splatski/hackyflasher/README.md

# Hacky Flasher

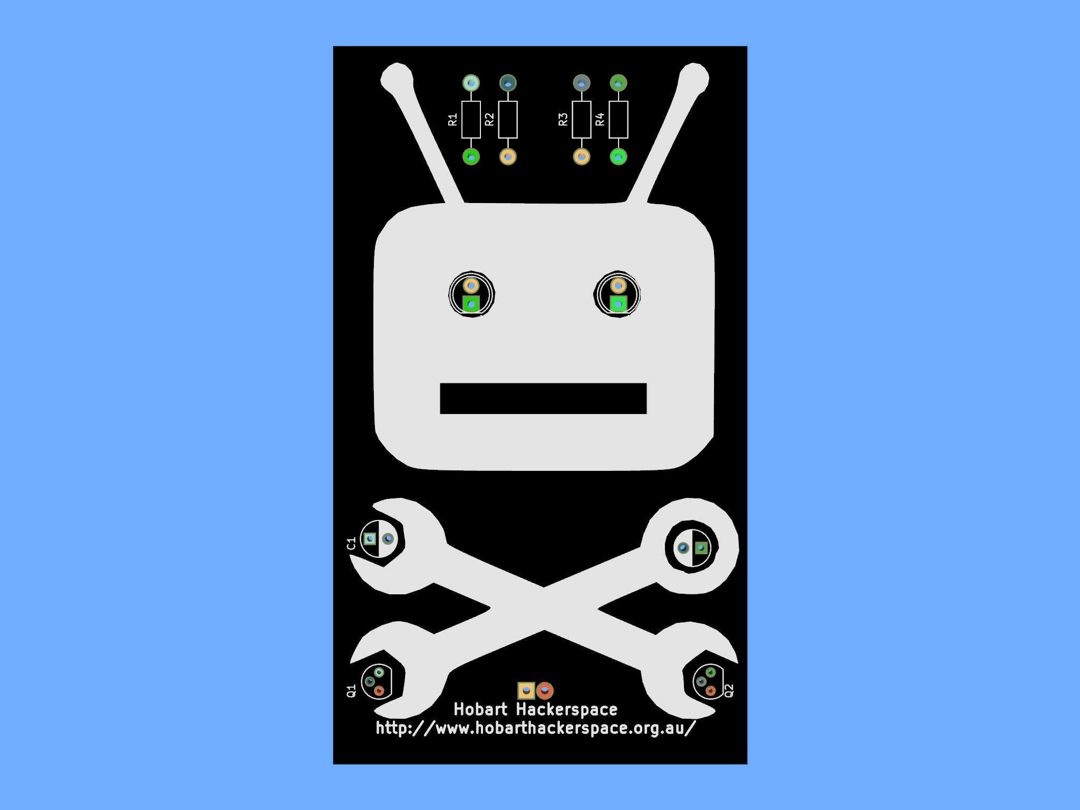
[picture p1: PCB-Front.png]
Image of Hacky Flasher Front
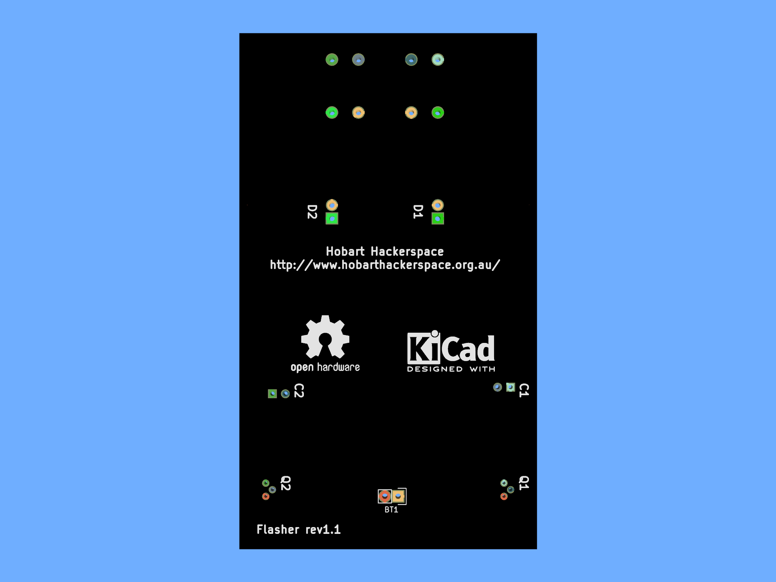
[picture p2: PCB-Back.png]
 

Soldering Workshop Board for Hobart Hackerspace.

---

## Assembly Instructions

Instructions Available here as
[HTML](https://splatski.github.io/hackyflasher/SolderingTutorialHackyFlash.html) or
[PDF](https://splatski.github.io/hackyflasher/SolderingTutorialHackyFlash.pdf)

---

## Licence
Licensed under the TAPR Open Hardware License (www.tapr.org/OHL). The "license" folder within this repository also contains a copy of this license in plain text format.
