splatski/hackyflasher/docs/PCB-Back.png

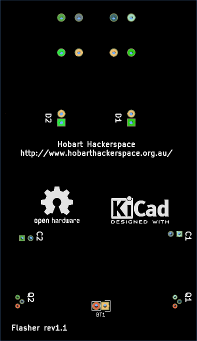
docs/PCB-Back.png
