splatski/hackyflasher/docs/PCB-Front.png

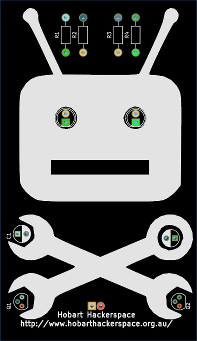
docs/PCB-Front.png
