splatski/hackyflasher/Flasher.kicad_pcb

## KiCad design Flasher.kicad_pcb (2017-01-17)

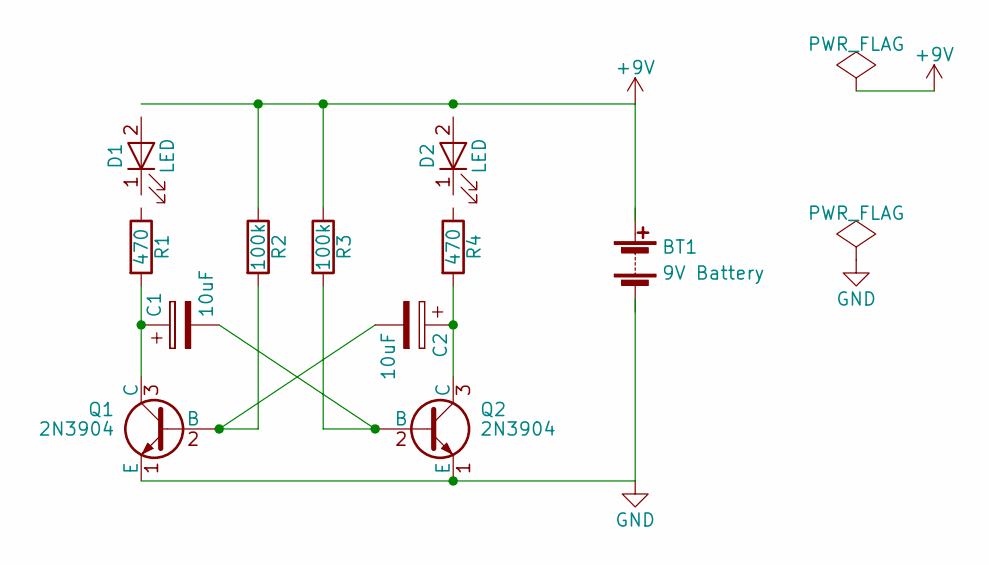
[picture p5: schematic Flasher.sch]

Parts:
BT1: 9V Battery; Pin_Header_Straight_1x02
C1, C2: 10uF; C_Radial_D5_L6_P2.5
D1, D2: LED; LED-5MM
Q1, Q2: 2N3904; TO-92_Rugged
R1, R4: 470; Resistor_Horizontal_RM10mm
R2, R3: 100k; Resistor_Horizontal_RM10mm

Connections:
+9V: BT1.1 (+), D1.2 (A), D2.2 (A), R2.1, R3.1
GND: BT1.2 (-), Q1.1 (E), Q2.1 (E)
unnamed: C1.1, Q1.3 (C), R1.2
unnamed: C1.2, Q2.2 (B), R3.2
unnamed: C2.1, Q2.3 (C), R4.2
unnamed: C2.2, Q1.2 (B), R2.2
unnamed: D1.1 (K), R1.1
unnamed: D2.1 (K), R4.1

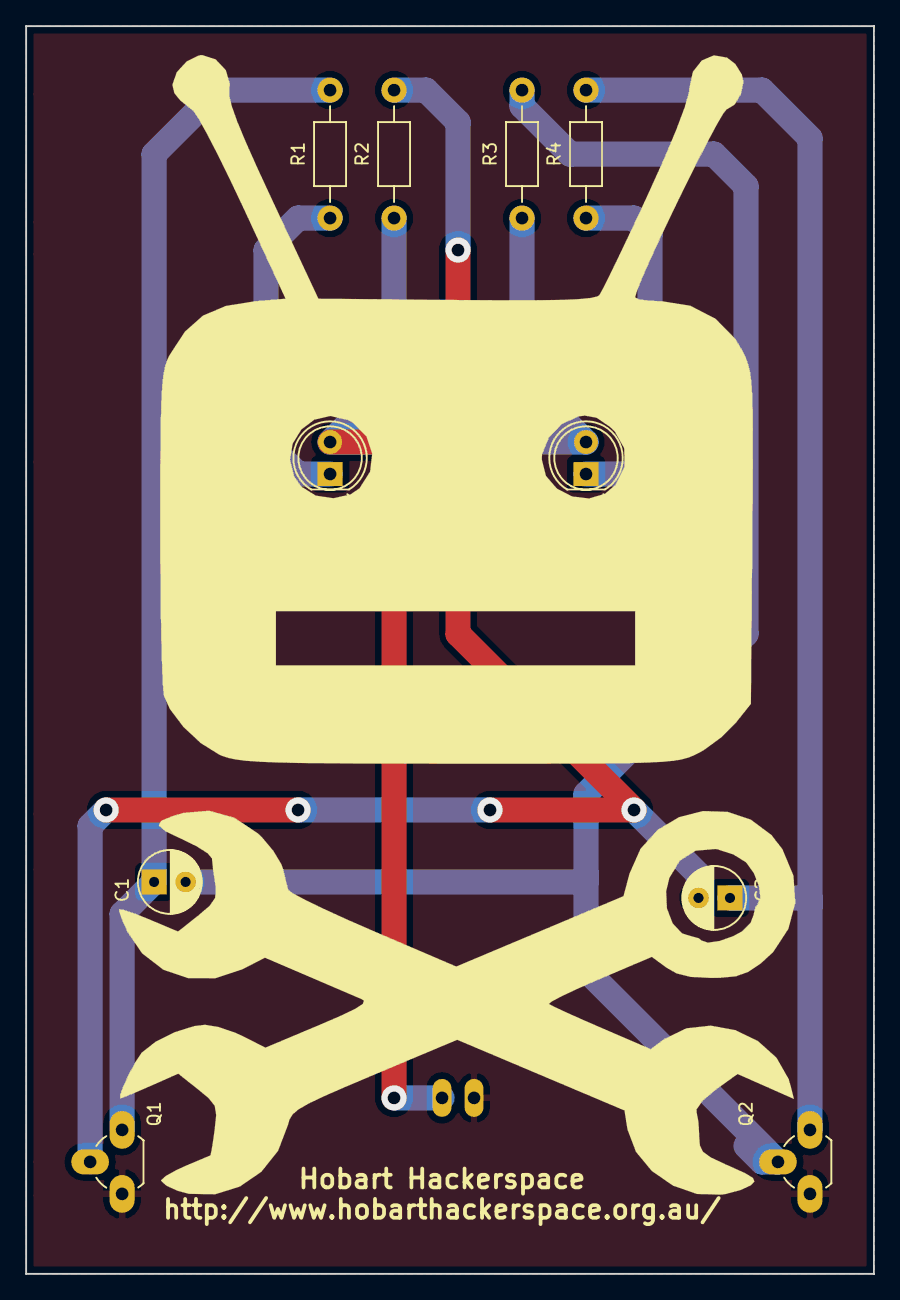
[picture p6: board Flasher.kicad_pcb from above]

Board: 2 copper layers, 67.3 x 99.1 mm, 11 parts (1 on the bottom side), 8 nets.
