splatski/hackyflasher/(commit log)

2017-01-17 add all the files!
    [Flasher.kicad_pcb, Flasher.sch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]
2017-01-18 cropped pcb front and back images
2017-01-18 scaled down pcb-front
2017-01-18 scaled down pcb-back
2017-01-18 add pcb back to readme
2017-01-19 add link to assembly guide to readme
